JoaCieri/ProyectoFinal2026/Software/Modelo_Medidas_2/rsc/multimetro.PNG

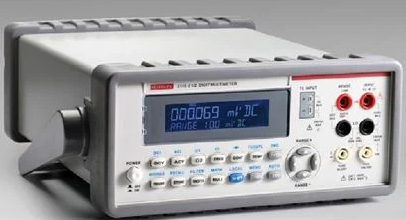
Software/Modelo_Medidas_2/rsc/multimetro.PNG
