JoaCieri/ProyectoFinal2026/Software/Modelo_Medidas_2/rsc/fuente_alimentacion.png

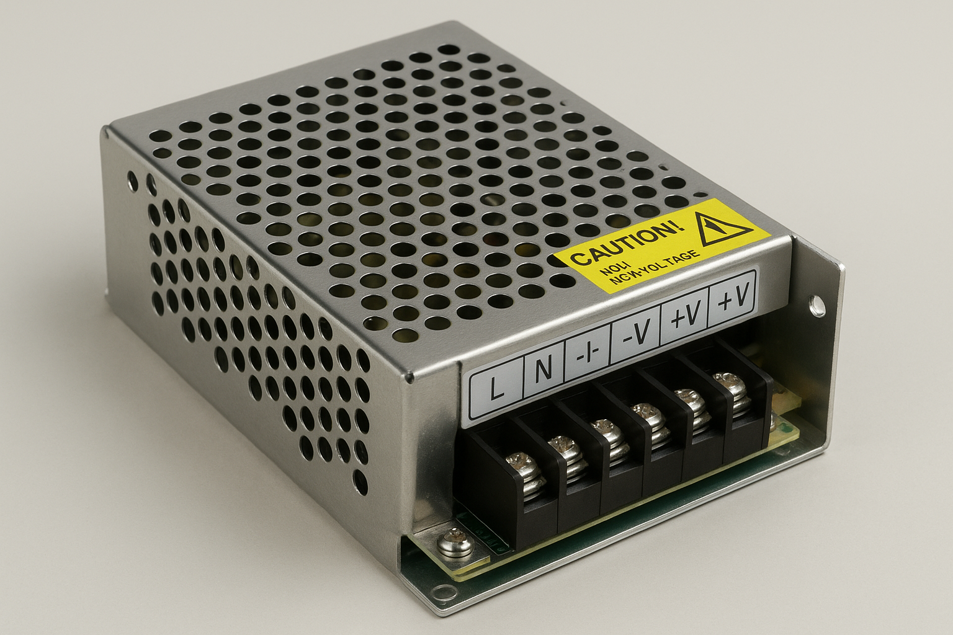
Software/Modelo_Medidas_2/rsc/fuente_alimentacion.png
