JoaCieri/ProyectoFinal2026/firmware/doc/pinout.docx

Función | Señal | Pin | Detalle
ADC interno (3 fases) | V1 | PA0 | ADC1_IN0
| I1 | PA1 | ADC1_IN1
| V2 | PA2 | ADC1_IN2
| I2 | PA3 | ADC1_IN3
| V3 | PB0 | ADC1_IN8
| I3 | PB1 | ADC1_IN9
I2C1 (bus compartido) | SCL | PB8 | DS3231=0x68, AT24C32=0x50, ADS1115=0x48
| SDA | PB9
TIM4 (Encoder KY-040) | A | PB6 | Encoder Mode TI1+TI2
| B | PB7
Encoder | SW (pulsador) | PC15 | Input, pull-up
SPI2 (bus compartido: Display+SD+ETH×2) | SCK | PB13
| MISO | PB14
| MOSI | PB15
Display ILI9341 | CS | PB12
| DC | PA8
| RST | PB10
MicroSD | CS | PB3 | (pin JTDO, libre por Debug=Serial Wire)
W5500 #1 (SCADA) | CS | PA15 | (pin JTDI, libre por Debug=Serial Wire)
W5500 #2 (PC local) | CS | PB5
W5500 #1 y #2 | RST (compartido) | PC14
Sistema / fijos | LED | PC13 | activo en bajo
| Debug | PA13 / PA14 | SWDIO / SWCLK (Serial Wire)
| Flash SPI1 on-board | PA4, PA5, PA6, PA7, PB4 | no usar, ocupado por la flash de la placa
| BOOT1 | PB2 | no usar como GPIO
| Reservado UART debug | PA9, PA10 | libre para futuro
| Reservado USB | PA11, PA12 | libre para futuro

- Display, SD y los 2 Ethernet comparten un único bus SPI2; cada uno se selecciona por su propio CS.
- Los 2 W5500 comparten una sola línea de RST (resetean juntos).
- Los INT de los W5500 no se usan — el estado se consulta por polling SPI en vez de interrupción por hardware.
- Backlight del display: se recomienda atarlo directo a 3,3V en la placa (sin control por GPIO) para no gastar un pin más.
- No queda ningún pin GPIO libre de margen — el pinout usa el 100%

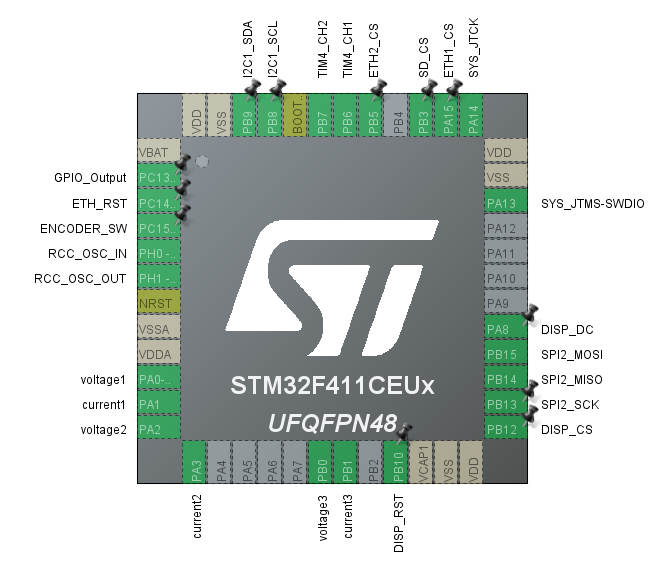
[picture p3: figure]
