JoaCieri/ProyectoFinal2026/firmware/doc/IVb. Migracion a Blackpill.docx

Migración a Blackpill

Reconfiguracion de puertos necesaria:

Tiene un chip en la parte inferior de la placa PUYA P25Q64HA es un chip Flash NOR SPI de 64Mbit (8MB) lo que plantea un cambio en la elección de los puertos:

fase 3 (voltage3/current3) va a PB0/PB1, evitando el bus de la Flash.

reloj a 100MHz, TIM3 disparando a 5kHz, ADC1 con los 6 canales remapeados y DMA en modo circular con interrupciones

Rank | Señal | Canal | Pin (antes F103) | Pin (ahora F411)
1 | voltage1 | IN0 | PA0 | PA0 (igual)
2 | current1 | IN1 | PA1 | PA1 (igual)
3 | voltage2 | IN2 | PA2 | PA2 (igual)
4 | current2 | IN3 | PA3 | PA3 (igual)
5 | voltage3 | IN8 | PA5 | PB0 (remapeado)
6 | current3 | IN9 | PA6 | PB1 (remapeado)

Estructura modular

Archivo | Contenido
signals.h/.c | Arrays calibrados, offsets, ganancias, resultados (RMS, THD, potencia, eventos)
acquisition.h/.c | ProcessADCBuffer(), callbacks de DMA, CalibrateOffset(), ApplyCalibration(), buffer crudo
measurements.h/.c | Con separadores ////// por sección: RMS/frecuencia, armónicos, potencia, eventos
processing.h/.c | ProcessMeasurements(), el orquestador
