JoaCieri/ProyectoFinal2026/firmware/doc/IV. Analisis Electrico.docx

Tarea III: Análisis Eléctrico

Commit:

# Calculo de magnitudes:

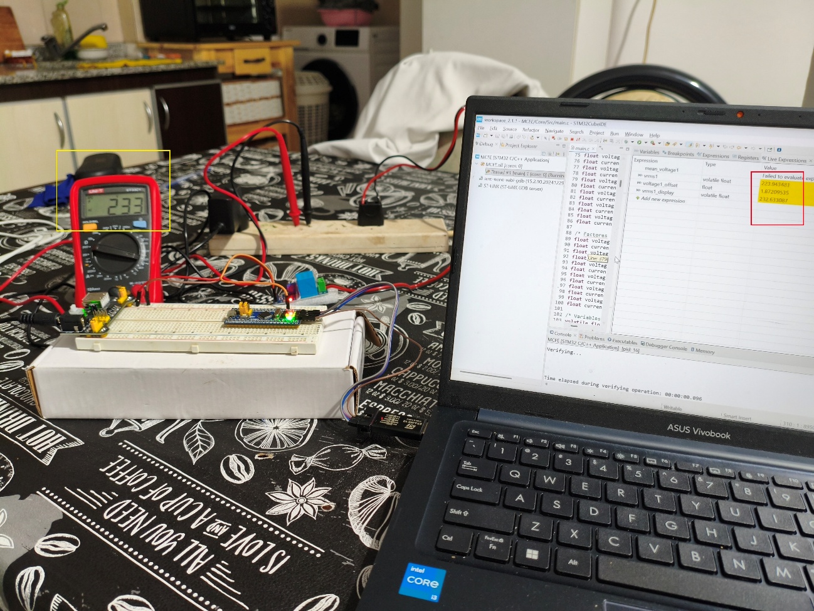
[picture p6: figure]

Se observa:

Voltimetro:233V Medidor: 232,63 V

Funciones: CalculateMean y CalculateRMS

Medición de frecuencia de línea: Utilizamos algoritmo de medición de cruce por cero.

# Armonicos y Eventos

Debido a la limitación de memoria que presenta el microcontrolador elegido y la ausencia de una FPU, el costo computacional que implica realizar un análisis espectral por medio de una transformada rápida de Fourier es muy alto. Además, según lo garantizado, nuestro equipo debe cumplir con la normativa IEC61000-4-7 la cual exige que los instrumentos que miden armónicos lleguen hasta el n°40, no en la totalidad del espectro de frecuencias. Con los parámetros de diseño adoptados hasta ahora podríamos medir hasta el armónico 50, que está muy cerca del limite más adelante veremos si es necesario aumentar un poco más la frecuencia de muestreo u algún otro parámetro.

Por los motivos anteriores, en lugar de usar fft, decidimos implementar una lógica de cálculo utilizando un algoritmo de Goertzel. Este nos permite calcular solo las componentes espectrales que nos interesan reduciendo el costo computacional notablemente y cumpliendo con la consigna. Como contraposición no podremos implementar una detección automática de interarmonicos, al menos en esta versión, pero dicha prestación no fue proyectada durante la etapa de inicio.

Algoritmo de Goertzel

Objetivo: conocer la amplitud de una componente de frecuencia específica dentro de una señal muestreada. La herramienta clásica para esto es la Transformada Discreta de Fourier (DFT), que para una señal x[n] de N muestras calcula, para cada frecuencia (bin) k.

X[k]=∑_(n=0)^(N-1) x[n] e^(-j(2π)/N kn)

La FFT resuelve calculando la DFT completa para todo el espectro, para nuestro caso solo necesitamos la amplitud en frecuencias puntuales conocidas de antemano que son los múltiplos de 50Hz: 100Hz, 150Hz, 200Hz…

F_s =5000 Hz N=100 muestras

50Hz*50=2500 Hz (Nyquist)/2 (limite)

Fuera del orden que debe cumplir según Nyquist, la elección del juego de valores de la cantidad de muestras y el valor exacto de la frecuencia de muestreo es oportuno pero no aleatorio ya que:

(f_s)/N=(5000 Hz)/(100 muestras)=50 Hz

De esta forma:

k=1 => 50Hz

k=2 => 100Hz

k=3 => 150Hz

…

k=N => N*50Hz

Implementación:

La idea central consta de convertir la DFT en un filtro recursivo (IIR). Goertzel reformula el cálculo de X[k] como la respuesta de un filtro digital de segundo orden con retroalimentación (IIR), evaluado en N pasos. Esto es más eficiente que calcular la sumatoria de la DFT de forma directa, porque reutiliza resultados parciales en cada iteración en lugar de recalcular exponenciales complejas para cada término.

Goertzel define la relación de recurrencia:

s[n]=x[n]+2cos((2πk)/N)s[n-1]-s[n-2]

con condiciones iniciales:

s[-1]=s[-2]=0 iterando para n=0,1,...,N-1.

En la expresión podemos notar que el argumento del coseno es constante durante todo el barrido depende solo de “k” y “N” pero no de “n” por lo tanto cada muestra nueva requiere solo una multiplicación y dos sumas/restas, sin necesidad de tablas trigonométricas por cada paso ni de operar con números complejos en el lazo principal.

Una vez procesadas las N muestras reconstruimos el valor complejo X[k] a partir de los últimos 2 estados del filtro s[N-1] y s[N-2]:

Re{X[k]}=s[N-1]-s[N-2] cos((2πk)/N)

Im{X[k]}=s[N-2] sin((2πk)/N)

Luego para obtener la amplitud pico real de la componente senoidal correspondiente (no el valor crudo de la DFT), se normaliza por 2/N:

A_k =2/N |X[k]| [Vp]

El factor de normalización 2/N se debe a que cuando tomamos N muestras reales de una señal senoidal pura de amplitud pico A, la energía de esa componente se reparte simétricamente entre el bin k y su "espejo conjugado" en N−k (una propiedad de la DFT de señales reales). De esta forma Multiplicar por 2/N compensa esa repartición y recupera el pico real A de la senoidal.

Condición de borde IMPORTANTE

Es importante destacar que la fórmula de normalización 2/N vale para bins k estrictamente entre 0 y N/2. En el caso límite del armonico 50 con k=N/2 (bin de Nyquist exacto: k=50), el punto espejo coincide consigo mismo en vez de estar duplicado, y ahí el factor correcto es 1/N en lugar de 2/N, si no se corrige en este caso da el doble de la amplitud real. Como la norma pide hasta el armónico 40, nunca llegamos a tocar ese caso extremo, así que no afectaría el cálculo pero se debe tener en cuenta si decidimos modificar la frecuencia de muestreo o la cantidad de muestras.

Valor RMS

Como la señal de entrada ya está en Volts (como lo determinamos en las tareas anteriores de adquisición y procesamiento de señales) la amplitud hereda las unidades de forma directa. Es importante destacar que el resultado son amplitudes pico no rms, luego:

V_(rms_k) =(A_k)/(√2)

lo tengo que tener en cuenta después para no errarle al cálculo del THD.

INTENSIDAD DE CORRIENTE

Se implementó la lógica de medición de corriente rms igual que la de tensión, por el momento no se agregó la lógica de dipswitchs de selección de R de burden ni la relación de los TI ya que dependen de la placa los puertos que se usen y no se puede validar.

POTENCIA ACTIVA/REACTIVA/APARENTE

Se implementó una lógica para calcular potencia activa, reactiva, aparente y factor de potencia a partir de los valores de tensión y corriente rms.

SAG/SWELL: Se implementó lógica a partir de maquina de estados que fluctúa entre 3 estados EVENT_NONE, EVENT_SWELL, EVENT_SAG. Se probó con VRMS1 y funciona correctamente. Tener en cuenta que el nivel de tensión de referencia está hardcodeado.

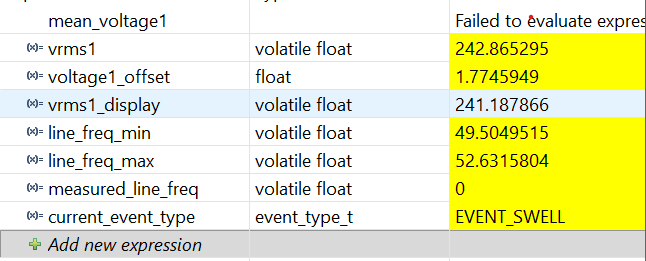
[picture p7: figure]

FRECUENCIA: Se implementó lógica para calculo máximo y mínimo y acotar el valor midiendo los cruces por cero pero tiene mucho ruido.

HISTERESIS: Se implementaron ajustes por histéresis para evitar detecciones falsas por oscilación en el umbral.

IMPORTANTE

En esta instancia resultó muy difícil efectuar las mediciones de forma certera ya que variaban demasiado debido al ruido de alta frecuencia causado por las fuentes.
