JoaCieri/ProyectoFinal2026/firmware/doc/III. Procesamiento de señales.docx

Tarea III: Procesamiento de Señales

Commit:

# Calibración:

Desestimacion de mediciones: El equipo deshecha las mediciones que se toman durante los primeros 5 segundos desde que se energizo para evitar que se tomen muestras erróneas durante el proceso de calibración.

Calibracion offset: Se implementó la lógica tanto para tensión como para corriente que al encender el equipo mide el valor medio de cada una de las 6 entradas y lo promedia para eliminarlo del valor presentado en pantalla. De esta forma no es necesario hardcodear dicho offset que puede variar dependiendo de cada sensor, de las condiciones de medición y del tiempo de uso.

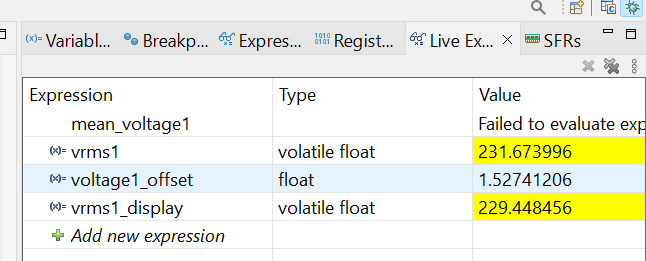
[picture p8: figure]

Calibracion de ganancia de sensores: Para este caso si se implementó lógica para medir y hardcodear los factores de ajuste de ganancia provisoria. En este caso para hacer una calibración hay que inyectar una señal conocida e indicarle al equipo su amplitud que debe estar medida con un instrumento calibrado, de esta forma:

A=(V_(out) (Medida por el micro))/(V_(in) (Inyectada y medida externamente))

Dejamos la medición sin ajustar de forma que:

A=1

Con un multímetro:

- Marca UNI-T
- Modelo UT33C+
- Rango 600Vac

Medimos la tensión de red:

V_(in) =228 V

Obtenemos:

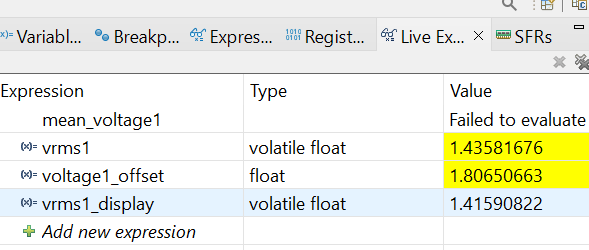
[picture p9: figure]

V_(out) =1,4159V

Por lo tanto:

A=(228 V)/(1,4159V)=161,028

Luego de la calibración:

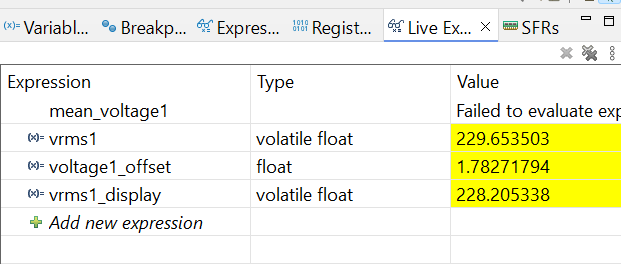
[picture p10: figure]

# Filtrado Digital

Filtrado digital: No podemos aplicar un LPF agresivo porque se estaría eliminando toda la parte de los transitorios, variaciones rápidas y eventos de tensión de la señal que es lo que principalmente queremos medir para determinar la calidad de la energía.

Filtro de outliers: Veremos mas adelante cuando analicemos los fenómenos anteriores si podemos plantear un filtro estadístico, de rango o de outliers que no afecte la señal ni provoque un sesgo en los resultados.

Filtro FIIR: Si vamos a diseñar un Filtro FIIR para obtener solo las componentes de los armónicos que nos interesan sin necesidad de aplicar una fft para analizar el espectro de frecuencias completo que incrementaría notablemente el costo computacional.
