JoaCieri/ProyectoFinal2026/firmware/doc/II. Adquisicion de señales.docx

Tarea II: Adquisicion de Señales

Commit: 888198b (https://github.com/JoaCieri/ProyectoFinal2026/commit/888198bfde75ddb73b459aa57fe8743d31f58e5f)

Se construyó el driver del ADC y DMA según las pautas determinadas en la tarea I.

Para validar las mediciones obtenidas a partir de la adquisición y el procesamiento de las muestras:

1) Generamos una cuadrada de valor medio 1,65 V y la reinyectamos en los puertos 2 y 3 del ADC. En la imagen se ve que coincide el valor del multímetro con los leídos por el ADC Imagen de la toma de medición:

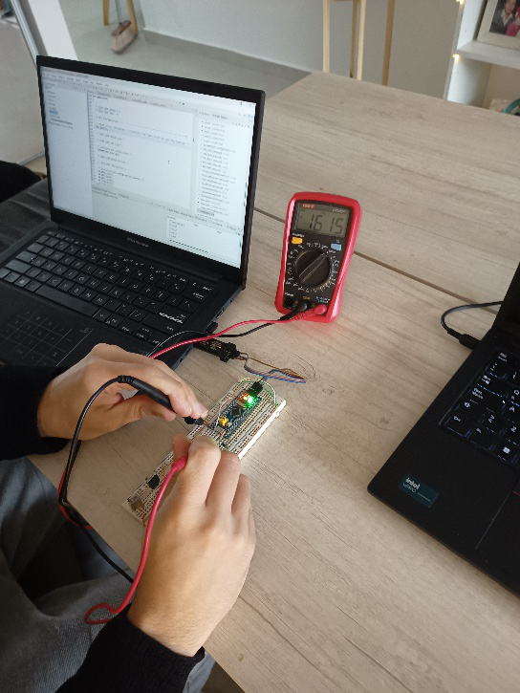
[picture p11: figure]

Captura de Live Expressions del IDE:

2) Utilizando la función PWM del micro se genero una señal cuadrada y se la modulo mediante una tabla con valores entre el 10% y el 90% del valor pico para emular una pseudo senoidal y validar el valor RMS.

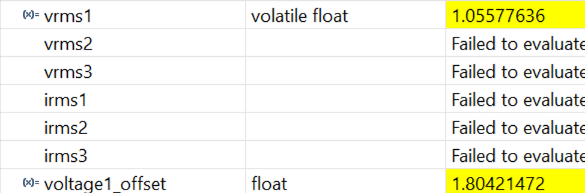
[picture p12: figure]

V_(1_(RMS)) =(0,9 V_p)/(√2)=(0,9 1,65V)/(√2)=1,05V

Conclusiones:

- El ADC está tomando correctamente las muestras y se están almacenando en la DMA.
- El calculo del valor medio de la señal funciona correctamente.
- La calibración por offset se está aplicando correctamente.
- El calculo de valor eficaz funciona correctamente
