JoaCieri/ProyectoFinal2026/Software/Modelo_Medidas_2/Incertidumbres.pdf

Efécto de Linea

Expresión del valor indicado:

EL =

ΔVout

ΔVin

=

Vout10% − Vout−10%

Vin10% − Vin−10%
Cada una de las cuatro mediciones está afectada por las siguientes fuentes de incertidumbre:

ΔVxp
Vxp

= ± {elect + erep}

x: in ó out

p : 10% ó − 10%
Fuentes de incertidumbre tipo B: El error de lectura el fabricante lo especifica en el manual del equipo por medio de eL que es un valor porcentual y constante, y con eR que también es porcentual y debe ser afectado por el rango utilizado en la medición. También se lo divide por el valor indicado para trabajar de forma relativa.

eLect :

(eL + eR ⋅

Rango
Vind

)

√3

%

Fuentes de incertidumbre tipo A: El error debido a la toma de valores en condiciones de repetibilidad lo calculamos dividiendo el desvío estandar de la muestra por la raiz cuadrada de la cantidad de mediciones tomadas y por el valor indicado para trabajar de forma relativa.

eRep :

σ

VInd√n

⋅ 100%

Calculamos la incertidumbre combinada para cada medición:

μc(Vxp) = √eLect
2 | + eRep
| 2

Si combinamos las incertidumbres de las mediciones, los coeficientes de sensibilidad quedan unitarios:

CVx10%

=

δΔVx

δVx10%

= 1 | CVx−10%

=

δΔVx

δVx−10%

= −1

Y la incertidumbre combinada para cada variación será:

uc(ΔVx

) = √(CVx10%
uc(Vx10%))

2
+ (CVx−10%

uc(Vx−10%))

2

Efectuar el análisis de incertidumbre sobre las variaciones de tensión facilita los calculos ya que los coeficientes de sensibilidad resultan unitarios:

CΔout =

δEL

δΔout=

1

Δin

Δout

Δin

Δout

= 1

CΔin =

δEL

δΔin=

−

Δout

Δin

2

ΔinΔin

Δout

= − 1

Luego combinamos las incertidumbres de las dos variaciones:

uc

(EL

) = √(CΔVin uc
(ΔVin))

2
+ (CΔVout uc

(ΔVout))

2

Calculamos los grados de libertad eficaces:

veff =

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
Con los grados de libertad eficaces y el intervalo de confianza elegido obtenemos el K mediante la función t-student implementada en python:

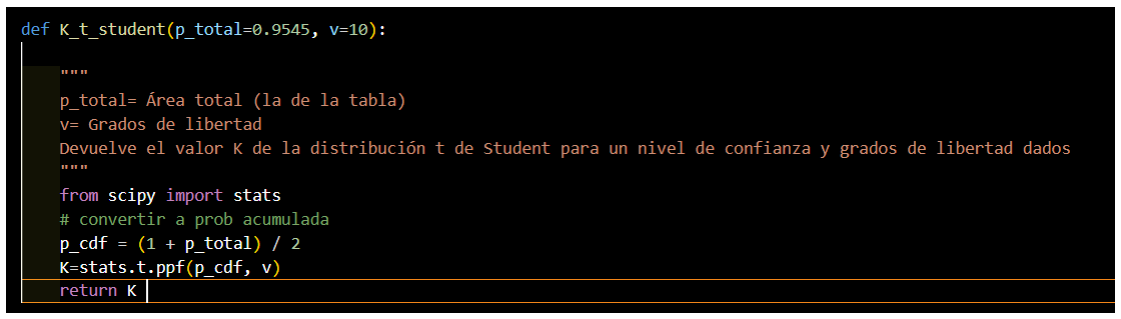
[picture p13: figure]

Finalmente calculamos la incertidumbre expandida como:

UC = K uc

Efecto de carga

Expresión valor indicado:

Ec =

VVACÍO − VCARGA

VVACÍO
Las fuentes de incertidumbre tienen las mismas expresiones con la diferencia de que las tensiones indicadas ahora corresponden con la tensión en vacío y con carga respectivamente.
Fuentes de incertidumbre tipo B: Especificado por el fabricante:

eLect :

(eL + eR ⋅

Rango
Vind

)

√3

%

Fuentes de incertidumbre tipo A: Estadistica

eRep :

σ

VInd√n

⋅ 100%

Calculamos la incertidumbre combinada para las dos mediciones:

μc

(VVACIO) = √eLect
2 + eRep

2
μc

(VCARGA) = √eLect
2 + eRep

2

Y en base a la expresión calculamos los coeficientes de sensibilidad relativos:

CVVACÍO

=

δEc

δVVACIO

=

VCARGA

VVACÍO

2

VVACÍOVVACÍO

VVACÍO − VCARGA

=

VCARGA

VVACÍO − VCARGA

CVCARGA =

δEc

δVCARGA

= −

1

VVACÍO

VCARGAVVACIO

VVACIO − VCARGA

= −

VCARGA

VVACIO − VCARGA
Luego combinamos las incertidumbres de las dos mediciones:

uc

(EC

) = √(CVVACIO uc
(VVACIO))

2
+ (CVCARGA uc

(VCARGA))

2

Calculamos los grados de libertad eficaces:

veff =

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
Y con los grados de libertad eficaces obtenemos el K de la función t-student de python y calculamos la incertidumbre expandida:

UC = K uc
