JoaCieri/ProyectoFinal2026/Software/Modelo_Medidas_2/rsc/esquemaRC2.PNG

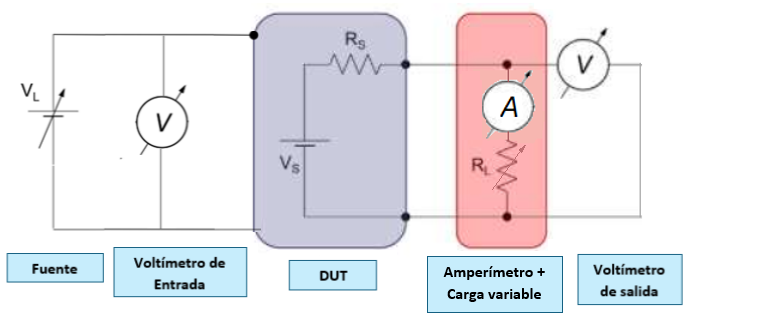
Software/Modelo_Medidas_2/rsc/esquemaRC2.PNG
