JoaCieri/ProyectoFinal2026/Software/Modelo_Medidas_2/rsc/esquemaRC.png

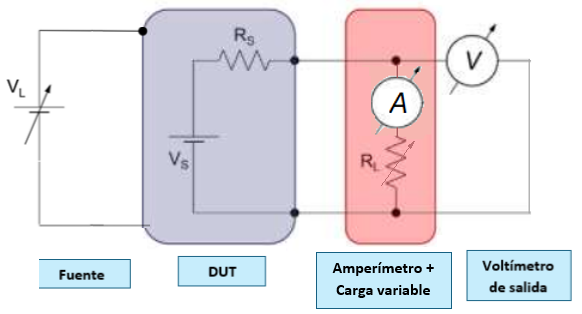
Software/Modelo_Medidas_2/rsc/esquemaRC.png
