JoaCieri/ProyectoFinal2026/Software/Modelo_Medidas_2/rsc/esquemaRL.PNG

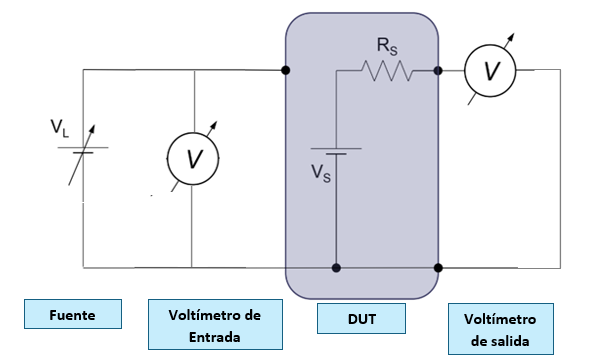
Software/Modelo_Medidas_2/rsc/esquemaRL.PNG
