JoaCieri/ProyectoFinal2026/Software/Modelo_Medidas_2/rsc/fuente.jpg

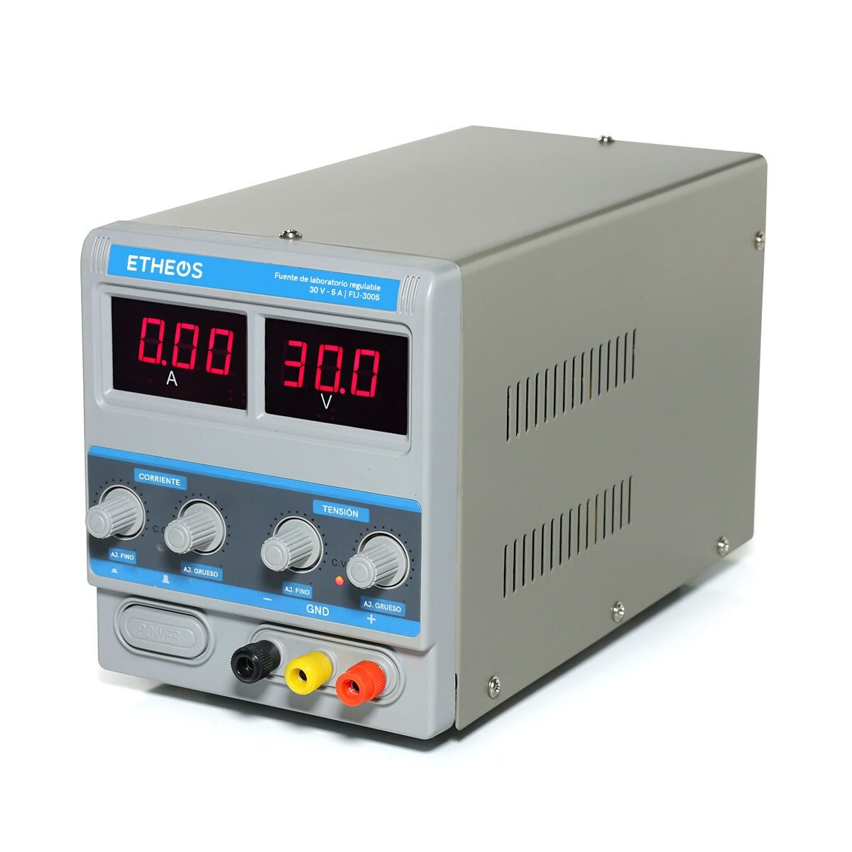
Software/Modelo_Medidas_2/rsc/fuente.jpg
