JoaCieri/ProyectoFinal2026/Software/Modelo_Medidas_2/rsc/regulador.PNG

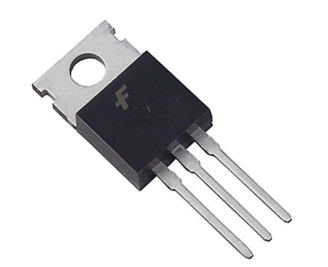
Software/Modelo_Medidas_2/rsc/regulador.PNG
