JoaCieri/ProyectoFinal2026/Hardware/PROTOTIPO_V9/LIBRERIAS/RTC/3013.step

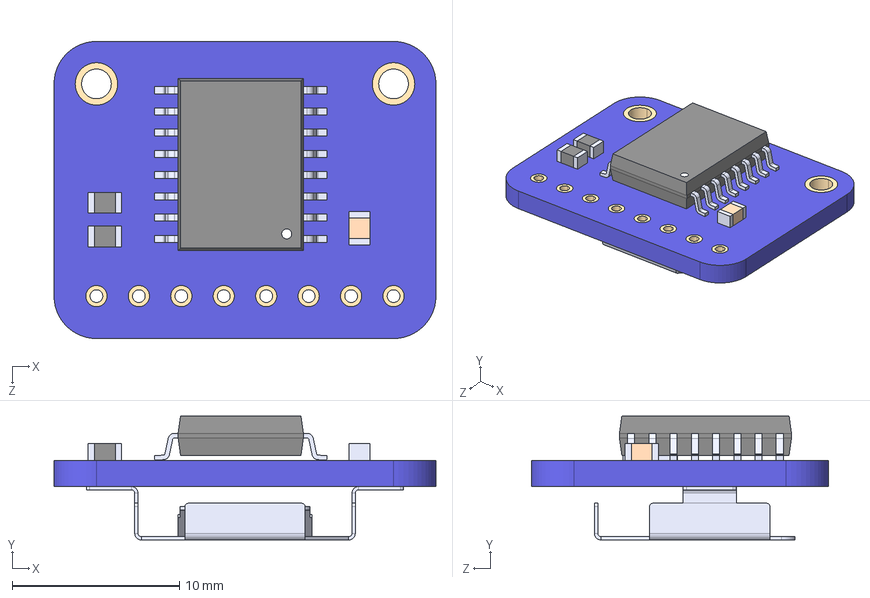
[picture p19: CAD file, 2026-09-20]
Hardware/PROTOTIPO_V9/LIBRERIAS/RTC/3013.step
22.9 x 7.42 x 17.8 mm
3001K-ND_3001K-ND
DS3231_SO_DS3231_SO
