JoaCieri/ProyectoFinal2026/Hardware/PROTOTIPO_V9/Impresión de circuitos/B.Cu (invertivo).pdf

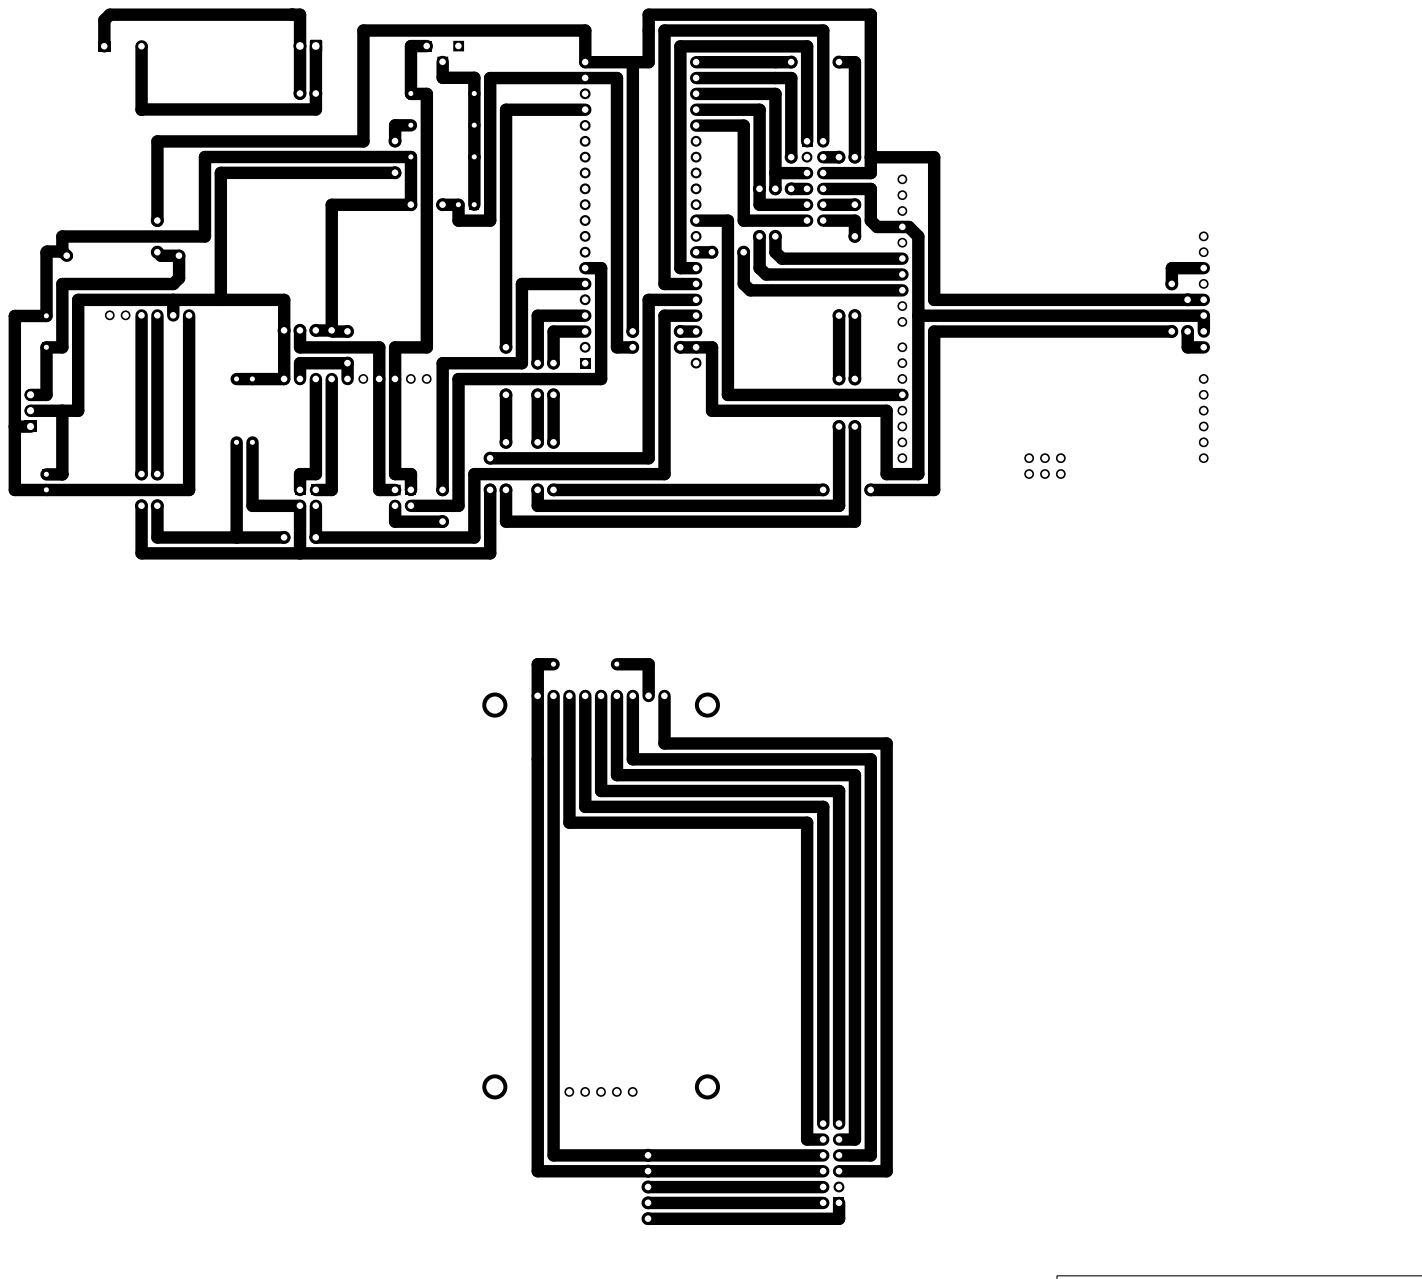
[picture p20: page 1]
