JoaCieri/ProyectoFinal2026/Hardware/PROTOTIPO_V9/Impresión de circuitos/F. Cu.pdf

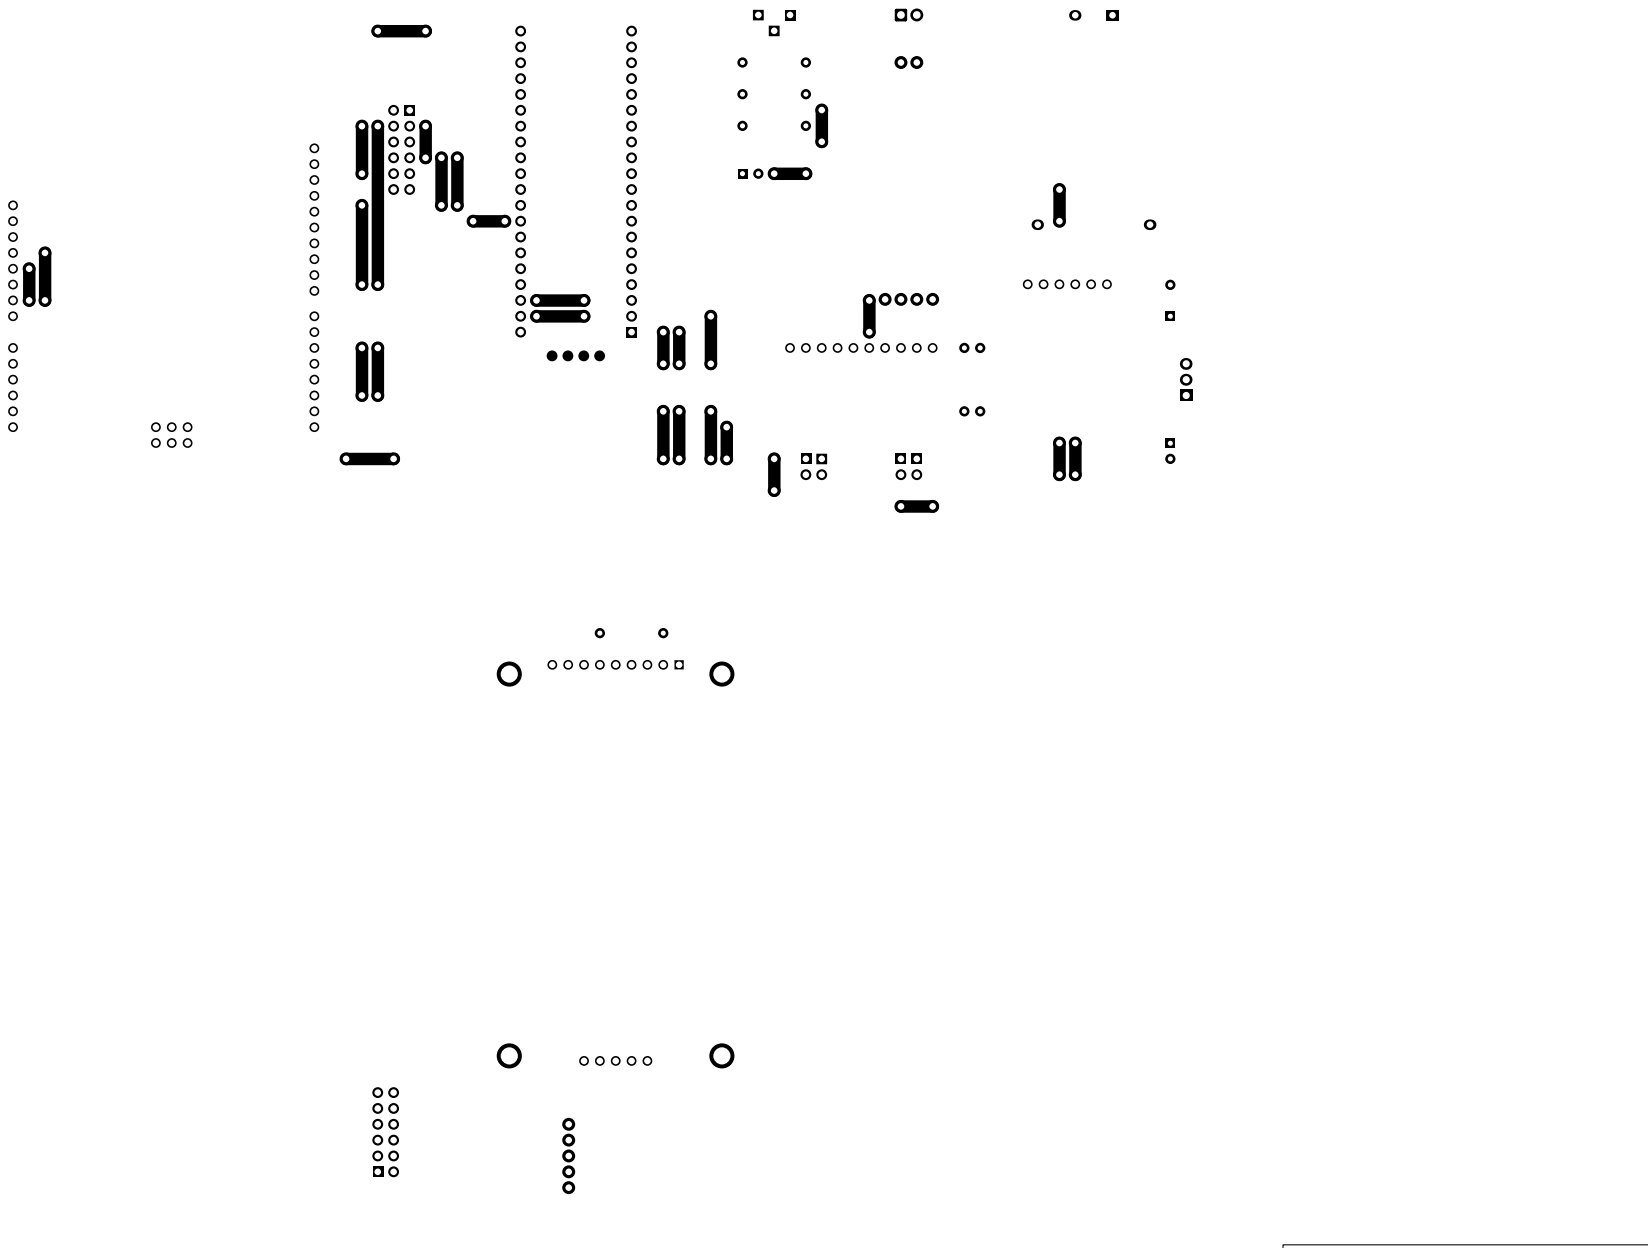
[picture p21: page 1]
