JoaCieri/ProyectoFinal2026/Hardware/PROTOTIPO_V9/Prototipo/Prototipo.kicad_pcb

## KiCad design Hardware/PROTOTIPO_V9/Prototipo/Prototipo.kicad_pcb (2026-10-14)

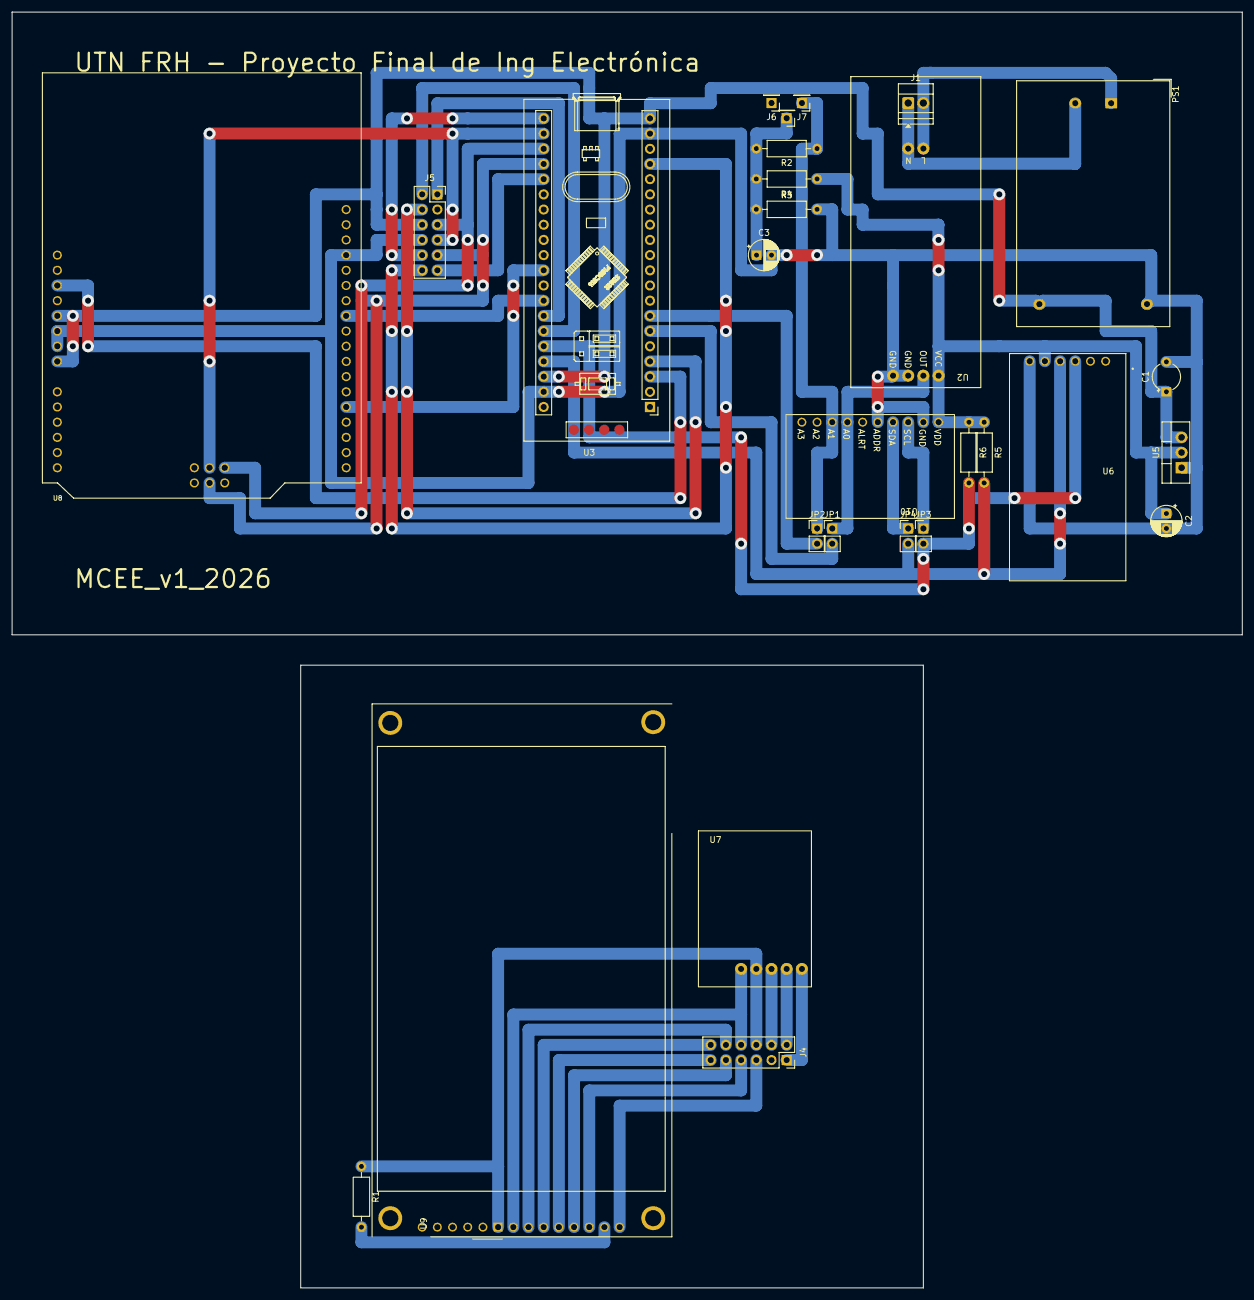
[picture p22: board Prototipo.kicad_pcb from above]

Board: 2 copper layers, 205.7 x 104.1 mm, 28 parts (0 on the bottom side), 38 nets.

Parts:
C1: 100n; CP_Radial_Tantal_D4.5mm_P5.00mm
C2, C3: 10u; CP_Radial_D5.0mm_P2.50mm
J1: Screw_Terminal_01x02; TerminalBlock_Xinya_XY308-2.54-2P_1x02_P2.54mm_Horizontal
J4, J5: Conn_02x06_Counter_Clockwise; PinSocket_2x06_P2.54mm_Vertical
J6, J7, J8: Conn_01x01; PinHeader_1x01_P2.54mm_Vertical
JP1, JP2, JP3, JP4: Jumper_2_Bridged; PinHeader_1x02_P2.54mm_Vertical
PS1: HLK-5M05; Converter_ACDC_Hi-Link_HLK-5Mxx
R1, R2: 100; R_Axial_DIN0207_L6.3mm_D2.5mm_P10.16mm_Horizontal
R3: 10K; R_Axial_DIN0207_L6.3mm_D2.5mm_P10.16mm_Horizontal
R4: 10k; R_Axial_DIN0207_L6.3mm_D2.5mm_P10.16mm_Horizontal
R5, R6: 1K5; R_Axial_DIN0207_L6.3mm_D2.5mm_P10.16mm_Horizontal
U2: zmpt101b; MODULE_ZMPT101B
U3: YAAJ_BlackPill_Part_Like_SWD_Breakout; YAAJ_BlackPill_SWD_1
U5: LD1117V33; TO-220-3_Vertical
U6: 3013; MODULE_3013
U7: KY-040; MODULE_KY-040
U8: W5500_ETHERNET_SHIELD
U9: CR2013-MI2120
U10: ADS1115IDGS; MODULE_ADS1115

Connections:
+3V3: C2.1, R4.1, R5.1, R6.1, U2.5 (VCC), U5.2 (VO), U6.1 (3.3V), U10.8 (VDD)
+5V: C1.1, J5.6 (Pin_10), PS1.4 (+Vout), U3.20 (5V), U3.38 (5V), U5.3 (VI), U8.5 (5V), U8.8 (VIN)
/ADS1115/ADC_SCL: JP3.1 (A), U10.10 (SCL)
/ADS1115/ADC_SDA: JP4.1 (A), U10.9 (SDA)
/DS3231/RTC_SCL: JP3.2 (B), R6.2, U3.36 (PB8), U6.3 (SCL)
/DS3231/RTC_SDA: JP4.2 (B), R5.2, U3.37 (PB9), U6.4 (SDA)
/PCB2CONNECTION/+5V_: J4.6 (Pin_10), R1.1, U7.VCC, U9.1 (VCC)
/PCB2CONNECTION/BUS_ENC_CLK: J5.1, U3.34 (PB6)
/PCB2CONNECTION/BUS_ENC_DT: J5.2 (Pin_12), U3.35 (PB7)
/PCB2CONNECTION/BUS_ENC_SW: J5.4 (Pin_11), U3.4 (PC15)
/PCB2CONNECTION/BUS_LCD_CS: J5.10 (Pin_8), U3.21 (PB12)
/PCB2CONNECTION/BUS_LCD_DC: J5.11 (Pin_6), U3.25 (PA8)
/PCB2CONNECTION/BUS_LCD_RST: J5.12 (Pin_7), U3.17 (PB10)
/PCB2CONNECTION/ENC_CLK: J4.1, U7.CLK
/PCB2CONNECTION/ENC_DT: J4.2 (Pin_12), U7.DT
/PCB2CONNECTION/ENC_SW: J4.4 (Pin_11), U7.SW
/PCB2CONNECTION/GND_: J4.8 (Pin_9), U7.GND, U9.2 (GND)
/PCB2CONNECTION/LCD_CS: J4.10 (Pin_8), U9.3 (~CS)
/PCB2CONNECTION/LCD_DC: J4.11 (Pin_6), U9.5 (D/~C)
/PCB2CONNECTION/LCD_MISO: J4.5 (Pin_3), U9.9 (MISO)
/PCB2CONNECTION/LCD_MOSI: J4.9 (Pin_5), U9.6 (MOSI)
/PCB2CONNECTION/LCD_RST: J4.12 (Pin_7), U9.4 (RESET)
/PCB2CONNECTION/LCD_SCK: J4.7 (Pin_4), U9.7 (SCK)
/SCT013_100A_1V/RING: C3.1, J8.1, R2.2, R3.1, R4.2
/SCT013_100A_1V/TOP: J7.1, JP2.1 (A), R2.1, U10.5 (AIN1)
/W5500/Eth_CS: U3.33 (PB5), U8.31 (D10)
/W5500/Eth_RST: U3.3 (PC14), U8.3 (RSIN)
/W5500/SD_CS: U3.31 (PB3), U8.25 (D4)
/ZMPT101B/TR_V_1_L: J1.2, PS1.1 (AC/L), U2.1 (L)
/ZMPT101B/TR_V_1_N: J1.1, PS1.2 (AC/N), U2.2 (N)
/ZMPT101B/TR_V_1_OUT: JP1.1 (A), U2.6 (OUT), U10.4 (AIN0)
GND: C1.2, C2.2, C3.2, J5.8 (Pin_9), PS1.3 (-Vout), R3.2, U2.3 (GND), U2.4 (GND), U3.19 (GND), U3.39 (GND), U5.1 (GND), U6.2 (GND), U8.6 (GND1), U8.7 (GND), U8.35 (GND0), U10.1 (ADDR), U10.3 (GND)
MISO: J5.5 (Pin_3), U3.23 (PB14), U8.17 (MISO)
MOSI: J5.9 (Pin_5), U3.24 (PB15), U8.19 (MOSI)
unnamed: JP1.2 (B), U3.6 (PA0)
unnamed: JP2.2 (B), U3.7 (PA1)
unnamed: R1.2, U9.8 (LED)
SCK: J5.7 (Pin_4), U3.22 (PB13), U8.16 (SCL)
