JoaCieri/ProyectoFinal2026/firmware/blackpill/MCEE/MCEE.ioc

Mcu.UserName=STM32F411CEUx
PA0-WKUP.GPIO_Label=voltage1
PA0-WKUP.Signal=ADCx_IN0
PA1.GPIO_Label=current1
PA1.Signal=ADCx_IN1
PA13.Signal=SYS_JTMS-SWDIO
PA14.Signal=SYS_JTCK-SWCLK
PA15.GPIO_Label=ETH1_CS
PA15.Signal=GPIO_Output
PA2.GPIO_Label=voltage2
PA2.Signal=ADCx_IN2
PA3.GPIO_Label=current2
PA3.Signal=ADCx_IN3
PA8.GPIO_Label=DISP_DC
PA8.Signal=GPIO_Output
PB0.GPIO_Label=voltage3
PB0.Signal=ADCx_IN8
PB1.GPIO_Label=current3
PB1.Signal=ADCx_IN9
PB10.GPIO_Label=DISP_RST
PB10.Signal=GPIO_Output
PB12.GPIO_Label=DISP_CS
PB12.Signal=GPIO_Output
PB13.Signal=SPI2_SCK
PB14.Signal=SPI2_MISO
PB15.Signal=SPI2_MOSI
PB3.GPIO_Label=SD_CS
PB3.Signal=GPIO_Output
PB5.GPIO_Label=ETH2_CS
PB5.Signal=GPIO_Output
PB6.Signal=S_TIM4_CH1
PB7.Signal=S_TIM4_CH2
PB8.Signal=I2C1_SCL
PB9.Signal=I2C1_SDA
PC13-ANTI_TAMP.Signal=GPIO_Output
PC14-OSC32_IN.GPIO_Label=ETH_RST
PC14-OSC32_IN.Signal=GPIO_Output
PC15-OSC32_OUT.GPIO_Label=ENCODER_SW
PC15-OSC32_OUT.Signal=GPXTI15
