JoaCieri/ProyectoFinal2026/firmware/blackpill/MCEE/Core/Src/main.c

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
/* Includes ------------------------------------------------------------------*/
#include "main.h"

/* USER CODE BEGIN Includes */
#include "signals.h"
#include "acquisition.h"
#include "processing.h"
#include "encoder.h"
#include "lvgl/lvgl.h"
#include "lvgl_port.h"
#include "gui.h"
#include "sd_card.h"
#include "i2c_devices.h"
#include "settings.h"
#include "test_logger.h"
#include "splash.h"

/* USER CODE END Includes */

ADC_HandleTypeDef hadc1;
DMA_HandleTypeDef hdma_adc1;

I2C_HandleTypeDef hi2c1;

SPI_HandleTypeDef hspi2;
DMA_HandleTypeDef hdma_spi2_tx;

TIM_HandleTypeDef htim3;
TIM_HandleTypeDef htim4;

void SystemClock_Config(void);
static void MX_GPIO_Init(void);
static void MX_DMA_Init(void);
static void MX_ADC1_Init(void);
static void MX_TIM3_Init(void);
static void MX_I2C1_Init(void);
static void MX_SPI2_Init(void);
static void MX_TIM4_Init(void);
/**
  * @brief  The application entry point.
  * @retval int
  */
int main(void)
{

  /* MCU Configuration--------------------------------------------------------*/

  /* Reset of all peripherals, Initializes the Flash interface and the Systick. */
  HAL_Init();

  /* Configure the system clock */
  SystemClock_Config();

  /* Initialize all configured peripherals */
  MX_GPIO_Init();
  MX_DMA_Init();
  MX_ADC1_Init();
  MX_TIM3_Init();
  MX_I2C1_Init();
  MX_SPI2_Init();
  MX_TIM4_Init();
  /* USER CODE BEGIN 2 */
  Encoder_Init();
  LvglPort_Init();
  Splash_Show();
  Gui_Init();
  DS3231_Init();
  Settings_Init();
  Splash_Finish();
  TestLogger_Init();
  /* primera pantalla completa, antes de arrancar el ADC */
  lv_refr_now(NULL);

  __HAL_DBGMCU_FREEZE_TIM3();   /* el muestreo se detiene mientras el depurador pausa */
  HAL_TIM_Base_Start_IT(&htim3);
  HAL_ADC_Start_DMA(&hadc1, (uint32_t*)adc_buffer, ADC_CHANNELS * DMA_BUFFER_SAMPLES);
  /* USER CODE END 2 */

  /* Infinite loop */
  /* USER CODE BEGIN WHILE */
  while (1)
  {
	  ProcessPendingBuffers();
	  lv_timer_handler();
	  TestLogger_Process();
    /* USER CODE END WHILE */

    /* USER CODE BEGIN 3 */
  }
  /* USER CODE END 3 */
}

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
