JoaCieri/ProyectoFinal2026/firmware/blackpill/MCEE/Core/Src/measurements.c

#include <math.h>
#include "measurements.h"
#include "signals.h"

////////////////////////////////////////////////////////////////////////////
// RMS, MEDIA Y FRECUENCIA DE RED
////////////////////////////////////////////////////////////////////////////

#define ZC_HYSTERESIS          3.0f   // volts; ajustable segun ruido observado
#define MIN_SAMPLES_PER_CYCLE  95     // ~52.6Hz maximo plausible (+5%)
#define MAX_SAMPLES_PER_CYCLE  105    // ~47.6Hz minimo plausible (-5%)

float CalculateRMS(float *signal)
{
    float sum = 0.0f;
    for (uint16_t i = 0; i < SAMPLES_PER_CYCLE; i++)
    {
        sum += signal[i] * signal[i];
    }
    return sqrtf(sum / SAMPLES_PER_CYCLE);
}

float CalculateMean(float *signal)
{
    float sum = 0.0f;
    for (uint16_t i = 0; i < SAMPLES_PER_CYCLE; i++)
    {
        sum += signal[i];
    }
    return sum / SAMPLES_PER_CYCLE;
}

/* Medicion continua de frecuencia.
 *
 * Se la llama con cada medio buffer, en orden: guarda el estado entre llamadas, asi que los
 * ciclos pueden empezar en un buffer y terminar en el siguiente (antes se buscaban dos cruces
 * dentro de un solo medio buffer de ~1.3 ciclos y la mayoria de las veces no los encontraba).
 *
 * - Cruce por cero ascendente con histeresis: se arma cuando la senial baja de -ZC_HYSTERESIS
 *   y se toma el cruce cuando pasa de negativa a positiva.
 * - El instante del cruce se interpola entre las dos muestras (fraccion de muestra), asi la
 *   resolucion no queda limitada a fs/periodo (0.5 Hz a 5 kHz).
 * - Se promedian FREQ_AVG_CYCLES ciclos validos (10 ciclos = 200 ms) antes de actualizar.
 * - Devuelve el ultimo valor valido; 0 si no hubo cruces durante FREQ_TIMEOUT_S (sin tension). */
#define FREQ_AVG_CYCLES   10
#define FREQ_TIMEOUT_S    0.5f

float MeasureLineFrequency(float *signal, uint16_t N, float fs)
{
    static uint8_t  armed = 0;           /* la senial estuvo claramente negativa */
    static uint8_t  have_ref = 0;        /* hay un cruce anterior de referencia */
    static float    prev = 0.0f;         /* ultima muestra del buffer anterior */
    static float    since_cross = 0.0f;  /* muestras desde el ultimo cruce (con fraccion) */
    static float    period_sum = 0.0f;
    static uint8_t  cycles = 0;
    static float    last_freq = 0.0f;

    for (uint16_t i = 0; i < N; i++)
    {
        float x = signal[i];
        since_cross += 1.0f;

        if (x < -ZC_HYSTERESIS)
        {
            armed = 1;
        }
        else if (armed && prev < 0.0f && x >= 0.0f)
        {
            /* el cero esta entre la muestra anterior y esta: a "frac" de la anterior */
            float frac = prev / (prev - x);          /* 0..1 */
            float after = 1.0f - frac;               /* del cruce a esta muestra */
            armed = 0;

            if (have_ref)
            {
                float period = since_cross - after;  /* del cruce anterior a este */
                if (period >= MIN_SAMPLES_PER_CYCLE && period <= MAX_SAMPLES_PER_CYCLE)
                {
                    period_sum += period;
                    if (++cycles >= FREQ_AVG_CYCLES)
                    {
                        last_freq  = fs * (float)cycles / period_sum;
                        period_sum = 0.0f;
                        cycles     = 0;
                    }
                }
                else
                {
                    /* ciclo raro (ruido, falta de senial): descartar el promedio en curso */
                    period_sum = 0.0f;
                    cycles     = 0;
                }
            }
            have_ref    = 1;
            since_cross = after;
        }
        prev = x;
    }

    /* Sin cruces durante mucho tiempo: no hay tension medible */
    if (since_cross > FREQ_TIMEOUT_S * fs)
    {
        have_ref    = 0;
        period_sum  = 0.0f;
        cycles      = 0;
        last_freq   = 0.0f;
        since_cross = FREQ_TIMEOUT_S * fs;   /* evita que crezca sin limite */
    }

    return last_freq;
}

////////////////////////////////////////////////////////////////////////////
// ARMONICOS Y THD
////////////////////////////////////////////////////////////////////////////

/* Calcula la amplitud del armonico "k" (k=1 es la fundamental) sobre un buffer de N muestras */
static float GoertzelMagnitude(float *signal, uint16_t N, uint16_t k)
{
    float w = 2.0f * 3.14159265f * k / N;
    float coeff = 2.0f * cosf(w);

    float s_prev = 0.0f;
    float s_prev2 = 0.0f;

    for (uint16_t i = 0; i < N; i++)
    {
        float s = signal[i] + coeff * s_prev - s_prev2;
        s_prev2 = s_prev;
        s_prev = s;
    }

    float real = s_prev - s_prev2 * cosf(w);
    float imag = s_prev2 * sinf(w);

    return (2.0f / N) * sqrtf(real * real + imag * imag);
}

void CalculateHarmonics(float *signal)
{
    for (uint16_t k = 1; k <= MAX_HARMONIC; k++)
    {
        voltage1_harmonics[k] = GoertzelMagnitude(signal, SAMPLES_PER_CYCLE, k);
    }

    float sum_sq_harmonics = 0.0f;
    for (uint16_t k = 2; k <= MAX_HARMONIC; k++)
    {
        sum_sq_harmonics += voltage1_harmonics[k] * voltage1_harmonics[k];
    }

    voltage1_thd = (voltage1_harmonics[1] > 0.0f)
        ? (sqrtf(sum_sq_harmonics) / voltage1_harmonics[1]) * 100.0f
        : 0.0f;
}

////////////////////////////////////////////////////////////////////////////
// POTENCIA (P, Q, S, FP)
////////////////////////////////////////////////////////////////////////////

/* Potencia de un ciclo.
 * P = promedio de v*i.
 * Q con signo: promedio de v(t - T/4) * i(t), es decir la tension atrasada un cuarto de ciclo
 * (25 muestras a 50 Hz y 5 kHz). Positiva = inductiva (la corriente atrasa), negativa = capacitiva.
 * Antes Q salia de sqrt(S^2 - P^2): no tenia signo y todo el ruido de la corriente aparecia como Q.
 * S y FP de un ciclo quedan como antes (los valores para mostrar se promedian en processing.c). */
#define Q_SHIFT   (SAMPLES_PER_CYCLE / 4)

void CalculatePower(float *voltage_ac, float *current_ac, float vrms, float irms)
{
    float sum_p = 0.0f;
    for (uint16_t i = 0; i < SAMPLES_PER_CYCLE; i++)
        sum_p += voltage_ac[i] * current_ac[i];
    p_active1 = sum_p / SAMPLES_PER_CYCLE;

    p_apparent1 = vrms * irms;

#if HALF_BUFFER_SAMPLES >= (SAMPLES_PER_CYCLE + Q_SHIFT)
    float sum_q = 0.0f;
    for (uint16_t i = 0; i < SAMPLES_PER_CYCLE; i++)
        sum_q += voltage_ac[i] * current_ac[i + Q_SHIFT];
    p_reactive1 = sum_q / SAMPLES_PER_CYCLE;
#else
    /* el medio buffer no alcanza para el desplazamiento: Q sin signo como antes */
    float q_sq = (p_apparent1 * p_apparent1) - (p_active1 * p_active1);
    p_reactive1 = (q_sq > 0.0f) ? sqrtf(q_sq) : 0.0f;
#endif

    power_factor1 = (p_apparent1 > 0.0f) ? (p_active1 / p_apparent1) : 0.0f;
}

////////////////////////////////////////////////////////////////////////////
// EVENTOS: SAG / SWELL
////////////////////////////////////////////////////////////////////////////

#define NOMINAL_VOLTAGE       220.0f
#define SAG_THRESHOLD_LOW     (0.90f * NOMINAL_VOLTAGE)
#define SAG_THRESHOLD_HIGH    (0.92f * NOMINAL_VOLTAGE)
#define SWELL_THRESHOLD_HIGH  (1.10f * NOMINAL_VOLTAGE)
#define SWELL_THRESHOLD_LOW   (1.08f * NOMINAL_VOLTAGE)

static event_type_t current_event_type = EVENT_NONE;
static uint32_t current_event_start = 0;
static float current_event_extreme = 0.0f;

void DetectVoltageEvents(float vrms)
{
    if (current_event_type == EVENT_NONE)
    {
        if (vrms < SAG_THRESHOLD_LOW)
        {
            current_event_type = EVENT_SAG;
            current_event_start = HAL_GetTick();
            current_event_extreme = vrms;
        }
        else if (vrms > SWELL_THRESHOLD_HIGH)
        {
            current_event_type = EVENT_SWELL;
            current_event_start = HAL_GetTick();
            current_event_extreme = vrms;
        }
    }
    else if (current_event_type == EVENT_SAG)
    {
        if (vrms < current_event_extreme) current_event_extreme = vrms;

        if (vrms >= SAG_THRESHOLD_HIGH)
        {
            if (events_count < MAX_EVENTS_LOG)
            {
                events_log[events_count].type = EVENT_SAG;
                events_log[events_count].start_time_ms = current_event_start;
                events_log[events_count].duration_ms = HAL_GetTick() - current_event_start;
                events_log[events_count].extreme_value = current_event_extreme;
                events_count++;
            }
            current_event_type = EVENT_NONE;
        }
    }
    else // EVENT_SWELL
    {
        if (vrms > current_event_extreme) current_event_extreme = vrms;

        if (vrms <= SWELL_THRESHOLD_LOW)
        {
            if (events_count < MAX_EVENTS_LOG)
            {
                events_log[events_count].type = EVENT_SWELL;
                events_log[events_count].start_time_ms = current_event_start;
                events_log[events_count].duration_ms = HAL_GetTick() - current_event_start;
                events_log[events_count].extreme_value = current_event_extreme;
                events_count++;
            }
            current_event_type = EVENT_NONE;
        }
    }
}
