JoaCieri/ProyectoFinal2026/firmware/blackpill/MCEE/Core/Inc/measurements.h

#ifndef MEASUREMENTS_H
#define MEASUREMENTS_H

#include "main.h"

////////////////////////////////////////////////////////////////////////////
// RMS, MEDIA Y FRECUENCIA DE RED
////////////////////////////////////////////////////////////////////////////
float CalculateRMS(float *signal);
float CalculateMean(float *signal);
float MeasureLineFrequency(float *signal, uint16_t N, float fs);

////////////////////////////////////////////////////////////////////////////
// ARMONICOS Y THD
////////////////////////////////////////////////////////////////////////////
void CalculateHarmonics(float *signal);

////////////////////////////////////////////////////////////////////////////
// POTENCIA (P, Q, S, FP)
////////////////////////////////////////////////////////////////////////////
void CalculatePower(float *voltage_ac, float *current_ac, float vrms, float irms);

////////////////////////////////////////////////////////////////////////////
// EVENTOS: SAG / SWELL
////////////////////////////////////////////////////////////////////////////
void DetectVoltageEvents(float vrms);

#endif /* MEASUREMENTS_H */
