JoaCieri/ProyectoFinal2026/(commit log)

2026-04-15 First commit
    Directory Tree
    Project structure
    bluepill configuration (clk-pll- 72MHz)
    Firmware initialization
    SD memory Driver
2026-05-19 GUI modelo Medidas 2
    Se cargan archivos de interfaz grafica de proyecto de medidas 2 como modelo.
2026-05-22 main y driver v1
2026-05-28 CLK TIMER ADC DMA MAIN
    CLK: Configuracion y seteo de PLL, divisores y prescaler.
    TIMER: Configuracion de timer controlador de trigger del ADC.
    ADC: Inicializacion, configuracion de parametros, muestras frecuencia, callbacks.
    DMA: Configuracion de buffer de cola para almacenar por DSP.
    MAIN: Logica para muestrar y calcular tension.
2026-08-10 Lectura de V e I
    Se logró adquisición de datos V e I, por medio de ADC, DMA, TIMER e INT. Se agregaron funciones para calcular valor medio y valor eficaz. Factor de escala.
2026-08-13 Calibracion automatica
    Offset: Medicion para no hardcodear el valor.
    Gain: por el momento 1 luego se vera como implementar procedimiento.
2026-08-17 Calibración
    Pruebas de construcción de senoidal a partir de señal PWM modulada para testear muestreo ADC, calculo de valor medio, RMS Y calibración de offset.
2026-08-17 Validacion Calibracion
    Se genero una cuadrada PWM modulada para emular una senoidal y validar el calculo RMS.
2026-08-19 Adquisición de Señales
    Driver de ADC/DMA, muestreo, calculo de offset, aplicación de calibración hardcodeada.
2026-08-21 Procesamiento de señales
    Calibración de offset automatica y ganancia de sensores por proceso.
    Filtrado digital.
2026-09-04 Driver Simulador
2026-09-05 SW-Leo datos del driver
2026-09-14 Creación de proyecto en KiCAD
    [Prototipo_MCEE.kicad_pcb, Prototipo_MCEE.kicad_sch]
2026-09-18 IV Calculo de magnitudes y eventos
    - Calculo de V e I RMS
    - Calculo de Frecuencia por cruce de 0.
    - Calculo de P,Q,S y FP.
    - Calculo de eventos SAG y SWELL con maquina de estados.
    [main.c]
2026-09-19 Hw v1
    [FUENTE.kicad_sch, Modulo ADC.kicad_sch, Modulo EEPROM.kicad_sch, Modulo Encoder.kicad_sch, Modulo Ethernet.kicad_sch, Modulo LED.kicad_sch, Modulo RTC.kicad_sch, Modulo Sensor de V_A.kicad_sch]
2026-09-19 Esquematico TR V 1 ,2 & 3
    [Modulo Sensor de V_A.kicad_sch, Prototipo.kicad_sch]
2026-09-19 Esquematico RTC
    [FUENTE.kicad_sch, Modulo RTC.kicad_sch, Modulo Sensor de V_A.kicad_sch, Prototipo.kicad_sch]
2026-09-19 Esquematico Encoder
    [Modulo Encoder.kicad_sch, Prototipo.kicad_sch]
2026-09-19 Libreria actualizada
    [Prototipo.kicad_sch]
2026-09-19 Se agrega sch/fp W5500, ILI9341 y fp BluePill
    [Modulo Encoder.kicad_sch, Modulo Ethernet.kicad_sch, Modulo LED.kicad_sch, Prototipo.kicad_pcb, Prototipo.kicad_sch]
2026-09-20 Sch DS3231 y adecuación de labels
2026-09-20 Bus de salida
    [CONN_BUS.kicad_sch, Modulo Encoder.kicad_sch, Modulo Ethernet.kicad_sch, Modulo LED.kicad_sch, Modulo RTC.kicad_sch, Prototipo.kicad_sch]
2026-09-20 sch ILI9341
    [Modulo Ethernet.kicad_sch, Modulo LED.kicad_sch, Modulo RTC.kicad_sch]
2026-09-20 sch ILI9341 y sch ADS1115
    [CONN_BUS.kicad_sch, Modulo ADC.kicad_sch, Modulo Ethernet.kicad_sch, Modulo LED.kicad_sch, Prototipo.kicad_sch]
2026-09-21 ERC: 0 errores
    [CONN_BUS.kicad_sch, Conector SCT013.kicad_sch, FUENTE.kicad_sch, Modulo Ethernet.kicad_sch, Modulo Sensor de V_A.kicad_sch, Prototipo.kicad_sch]
2026-09-21 Asignación de huellas
    [CONN_BUS.kicad_sch, Conector SCT013.kicad_sch, FUENTE.kicad_sch, Modulo ADC.kicad_sch, Modulo Encoder.kicad_sch, Modulo Ethernet.kicad_sch, Modulo LED.kicad_sch, Modulo RTC.kicad_sch]
2026-09-21 Planteo de PCBs
    [Prototipo.kicad_pcb]
2026-09-21 Esquematico TR de Corriente
    [Conector SCT013.kicad_sch, FUENTE.kicad_sch, Modulo ADC.kicad_sch, Modulo LED.kicad_sch, Modulo Sensor de V_A.kicad_sch, Prototipo.kicad_sch]
2026-09-22 Esquematico completo v1.0
    [Conector SCT013.kicad_sch, FUENTE.kicad_sch, Modulo Sensor de V_A.kicad_sch, Prototipo.kicad_sch]
2026-09-22 Footprints asignados
    [Conector SCT013.kicad_sch, Modulo Sensor de V_A.kicad_sch, Prototipo.kicad_sch]
2026-09-22 fp definitivos - Planteo de PCB con componentes
    [Conector SCT013.kicad_sch, Modulo ADC.kicad_sch, Modulo Encoder.kicad_sch, Modulo Sensor de V_A.kicad_sch, Prototipo.kicad_pcb]
2026-09-23 Ruteo de PCB Superior
    [CONN_BUS.kicad_sch, FUENTE.kicad_sch, Modulo Sensor de V_A.kicad_sch, Prototipo.kicad_pcb, Prototipo.kicad_sch]
2026-09-28 Migrar a BlackPill
    [Modulo LED.kicad_sch, Prototipo.kicad_sch]
2026-09-29 Migracion a Blackpill
    Migración de proyecto, y reconfiguración de hardware, frecuencias y bloques.
    Prueba de blinking correcta.
    [MCEE.ioc, main.c, main.h]
2026-09-29 Configuración de hardware
    TIMER, ADC, DMA y registros necesarios.
2026-09-30 Migración a blackpill
    Se migró todo el codigo, funciones, logica, maquinas de estados y variables al firmware de la blackpill.
    De paso se aprovechó para plantear una estructura modular de cada etapa o driver.
2026-09-30 Migración de sch a BlackPill
    [CONN_BUS.kicad_sch, Conector SCT013.kicad_sch, Modulo ADC.kicad_sch, Modulo Sensor de V_A.kicad_sch, Prototipo.kicad_pcb, Prototipo.kicad_sch]
2026-10-01 CubeMX
    Se configuraron todos los perisfericos, se setearon todos los parametros con el fin de determinar el pinout final
2026-10-04 Shc final y ruteo de PCB
    [Prototipo.kicad_pcb, Prototipo.kicad_sch]
2026-10-04 LVGL | ENCODER + DISPLAY
    Instalacion y configuracion de libreria LVGL
    Configuracion de hardware: Timers + GPIO para perifericos.
    Encoder: Funciones, callbacks e interfaz de prueba.
    Display: Funciones, DMA, logica y pantalla de prueba
2026-10-06 Encoder
    Codigo de encoder validado.
    Prueba de giro horario y antihorario con GND en puertos PB6 y PB7.
    Prueba de contadores.
    Implementación de rutina de antirebote para switch del encoder. Funcionando.
2026-10-06 LVGL | ENCODER | ADQ.
    Carga de libreria LVGL.
    Prueba y validación de convivencia de todos los modulos desarrollados hasta ahora.
    Ajuste de overruns por velocidad para evitar perdida de muestras.
    La prueba implica que no se afecta la adquisición mientras se renderiza la pantalla. No hay desbordes de memoria.
    Problema: 98% de la memoria flash consumida.
    [MCEE.ioc, acquisition.c, main.c]
2026-10-06 Optimizacion - I2C
    Cambio de optimizacion por size (Os-) para disminuir la flash que estaba en el 98%. Se redujo al 50%.
    i2C: Se agregaron las funciones para manejar el RTC y la eeprom.
2026-10-06 Settings
    Implementacion de set de funciones que llaman a los drivers y consultan la memoria para inicializacion del sistema.
2026-10-11 driver Ethernet | driver SD
    driver Ethernet: Construido a partir de archivos python de carpeta software.
    driver SD: Construido y la comunicación fue probada con el modulo.
2026-10-12 Carpeta drivers
2026-10-14 PCB Prototipo final
2026-10-24 Integración de placa I
    Implementacion de Test logger de integracion, rutinas para probar cada uno de los perifericos y validar su comportamiento.
2026-10-27 Testing
    Testing, validación y correcciones de bugs.
